LeviUdoh-17/waste_bin_ros/camera_ros/README.md

# ROS 2 node for libcamera

This ROS 2 node provides support for a variety of cameras via [libcamera](https://libcamera.org). Amongst others, this node supports V4L2 and [Raspberry Pi cameras](https://www.raspberrypi.com/documentation/computers/camera_software.html).

## Installation

Binary packages are available via the ROS package repository for some Linux and ROS distributions (check with `rosdep resolve camera_ros`). If it's available, you can install the DEB or RPM packages via:
```sh
# source a ROS distribution
source /opt/ros/$ROS_DISTRO/setup.bash
# DEB package
sudo apt install ros-$ROS_DISTRO-camera-ros
# RPM package
sudo dnf install ros-$ROS_DISTRO-camera-ros
```

> [!NOTE]
> This also installs the package [`libcamera`](https://index.ros.org/r/libcamera/) as dependency. This is the bloomed version of the official upstream repo at https://git.libcamera.org/libcamera/libcamera.git and may not contain full support for all Raspberry Pi camera modules. If you need full camera module support on Raspberry Pi, you have to build the "raspberrypi" fork from https://github.com/raspberrypi/libcamera manually.

## Build Instructions

### libcamera

The `camera_ros` node depends on libcamera version 0.1 or later. There are different ways to install this dependency:

- __System Package:__ Most Linux distributions provide a binary libcamera package. However, the Raspberry Pi OS uses a [custom libcamera fork](https://github.com/raspberrypi/libcamera) with additional support for newer camera modules. When using the distribution packages, you have to skip the `libcamera` rosdep key when resolving dependencies (`rosdep install [...] --skip-keys=libcamera`).

- __ROS Package:__ You can also install a newer version from the ROS repo (package `ros-$ROS_DISTRO-libcamera`). This package will be installed by default when building `camera_ros` from source and resolving the rosdep keys.

- __Source:__ Finally, you can always build libcamera from source. This is currently the only option for using the "raspberrypi" fork on Ubuntu. You can build libcamera as part of the ROS workspace using `colcon-meson`. This is recommended over a system-wide installation as it avoids conflicts with the system package. You will need to install the following dependencies:
    1. Install the libcamera build dependencies according to https://libcamera.org/getting-started.html#dependencies.
    2. Install `colcon-meson` via the package manager, `sudo apt install -y python3-colcon-meson`, or pip, `pip install colcon-meson`.

### camera_ros

The `camera_ros` package is built together with libcamera in a colcon workspace:
```sh
# create workspace
mkdir -p ~/camera_ws/src
cd ~/camera_ws/src

# check out libcamera
sudo apt -y install python3-colcon-meson
# Option A: official upstream
git clone https://git.libcamera.org/libcamera/libcamera.git
# Option B: raspberrypi fork with support for newer camera modules
# git clone https://github.com/raspberrypi/libcamera.git

# check out this camera_ros repository
git clone https://github.com/christianrauch/camera_ros.git

# resolve binary dependencies and build workspace
source /opt/ros/$ROS_DISTRO/setup.bash
cd ~/camera_ws/
rosdep install -y --from-paths src --ignore-src --rosdistro $ROS_DISTRO --skip-keys=libcamera
colcon build --event-handlers=console_direct+
```

If you are using a binary distribution of libcamera, you can skip adding this to the workspace. Additionally, if you want to use the bloomed libcamera package in the ROS repos, you can also omit `--skip-keys=libcamera` and have this binary dependency resolved automatically.

## Launching the Node

The package provides a standalone node executable:
```sh
ros2 run camera_ros camera_node
```
a composable node (`camera::CameraNode`):
```sh
ros2 component standalone camera_ros camera::CameraNode
```
and an example launch file for the composable node:
```sh
ros2 launch camera_ros camera.launch.py
```

## Interfaces

The camera node interfaces are compatible with the [`image_pipeline`](https://github.com/ros-perception/image_pipeline) stack. The node publishes the camera images and camera parameters and provides a service to set the camera parameters.

### Topics

| name | type | description |
| --- | --- | --- |
| `~/image_raw` | `sensor_msgs/msg/Image` | image |
| `~/image_raw/compressed` | `sensor_msgs/msg/CompressedImage` | image (compressed) |
| `~/camera_info` | `sensor_msgs/msg/CameraInfo` | camera parameters  |

### Services

| name | type | description |
| --- | --- | --- |
| `~/set_camera_info` | `sensor_msgs/srv/SetCameraInfo` | set camera parameters |

## Parameters

The node provides two sets of parameters:
1. static read-only parameters to configure the camera stream once at the beginning
2. dynamic parameters which are generated from the camera controls to change per-frame settings and which can be changed at runtime

Those parameters can be set on the command line:
```sh
# standalone executable
ros2 run camera_ros camera_node --ros-args -p param1:=arg1 -p param2:=arg2
# composable node
ros2 component standalone camera_ros camera::CameraNode -p param1:=arg1 -p param2:=arg2
```
or dynamically via the [ROS parameter API](https://docs.ros.org/en/rolling/Concepts/Basic/About-Parameters.html).

### Static Camera Stream Configuration

The camera stream is configured once when the node starts via the following static read-only parameters:

| name | type | description |
| --- | --- | --- |
| `camera` | `integer` or `string` | selects the camera by index (e.g. `0`) or by name (e.g. `/base/soc/i2c0mux/i2c@1/ov5647@36`) [default: `0`] |
| `role` | `string` | configures the camera with a `StreamRole` (possible choices: `raw`, `still`, `video`, `viewfinder`) [default: `viewfinder`] |
| `format` | `string` | a `PixelFormat` that is supported by the camera [default: auto] |
| `width`, `height` | `integer` | desired image resolution [default: auto] |
| `sensor_mode` | `string` | desired raw sensor format resolution (format: `width:height`) [default: auto] |
| `orientation` | `integer` | camera orientation in 90 degree steps (possible choices: `0`, `90`, `180`, `270`) [default: `0`] |
| `camera_info_url` | `string` | URL for a camera calibration YAML file (see [Calibration](#calibration)) [default: `~/.ros/camera_info/$NAME.yaml`] |
| `frame_id` | `string` | frame_id of the camera frame used in the header of the image messages |
| `use_node_time` | `boolean` | use node time instead of sensor timestamp for image message header [default: `false`] |

The configuration is done in the following order:
1. select camera via `camera`
2. configure camera stream via `role`
3. set the pixel format for the stream via `format`
4. set the image resolution for the stream via `width` and `height`
5. set the sensor mode resolution for the raw feed from camera to GPU

Each stream role only supports a discrete set of data stream configurations as a combination of the image resolution and pixel format. The selected stream configuration is validated at the end of this sequence and adjusted to the closest valid stream configuration.

By default, the node will select the first available camera and configures it with the default pixel format and image resolution. If a parameter has not been set, the node will print the available options and inform the user about the default choice.

The node avoids memory copies of the image data by directly mapping from a camera pixel format to a ROS image format, with the exception of converting between "raw" and "compressed" image formats when requested by the user. As an effect, not all pixel formats that are supported by the camera may be supported by the ROS image message. Hence, the options for `format` are limited to pixel formats that are supported by the camera and the raw ROS image message.

### Sensor Modes and Cropping

Most camera modules provide different sensor modes, some of which provide a smaller resolution version of the full picture, whereas others have a limited field-of-view, e.g. by allowing for the selection of a 3:2 image from a 16:9 sensor, a more native 'digital zoom' effect by cropping the picture etc. The benefit of this is to perform compute intensive tasks at the source (the sensor), rather than downstream in the GPU or in application code. Unless we specify the sensor mode we want, libcamera will automatically select one. Unfortunately, it is not guaranteed that the selected mode will be a full sensor mode, leading to a potential cropping of the picture.

Example: When configuring a 640x480 output stream on a Raspberry Pi Camera Module v2, libcamera will automatically choose a heavily cropped 640x480 sensor mode, leading to a digital zoom of ~2.5x.

See the [PiCamera2 Documentation, section 4.2.2.3](https://datasheets.raspberrypi.com/camera/picamera2-manual.pdf) for a detailed explanation. The [PiCamera Documentation](https://picamera.readthedocs.io/en/release-1.13/fov.html#sensor-modes) has a good visualization of the issue. Read the documentation of your camera to see what modes are available, and which (if any) raw formats are cropped.

### Dynamic Frame Configuration (controls)

The dynamic parameters are created at runtime by inspecting the [controls](https://libcamera.org/api-html/namespacelibcamera_1_1controls.html) that are exposed by the camera. The set of exposed controls is camera-dependent. The ROS parameters are directly formatted from the exposed controls, hence the parameter names match the control names.

libcamera does not expose the framerate directly as a parameter. Instead, the framerate range has to be converted to a duration:
$$\text{duration} = \frac{1}{\text{framerate}} \cdot 10^6 \\ µs$$
and then set via the control `FrameDurationLimits`, if it is exposed by the camera:
```sh
# set fixed framerate of 20 Hz (50 ms)
ros2 run camera_ros camera_node --ros-args -p FrameDurationLimits:="[50000,50000]"
```

## Calibration

The node uses the `CameraInfoManager` to manage the [camera parameters](https://docs.ros.org/en/rolling/p/image_pipeline/camera_info.html), such as the camera intrinsics for projection and distortion coefficients for rectification. Its tasks include loading the parameters from the calibration file, publishing them on `~/camera_info` and setting new parameters via service `~/set_camera_info`.

The URL for the camera calibration file can be set using the `camera_info_url` parameter, however it defaults to `~/.ros/camera_info/$NAME.yaml`. Note that when setting the URL manually, the provided string must be in the URL format, not a local file path (eg. `file:///home/nonroot/camera/calibration.yaml`). For more information, please take a look at the `CameraInfoManager` [API documentation](https://docs.ros.org/en/ros2_packages/rolling/api/camera_info_manager/generated/classcamera__info__manager_1_1CameraInfoManager.html).

If the camera has not been calibrated yet and the calibration file does not exist, the node will warn the user about the missing file (`Camera calibration file ~/.ros/camera_info/$NAME.yaml not found`) and publish zero-initialised intrinsic parameters. If you do not need to project between the 2D image plane and the 3D camera frame or rectify the image, you can safely ignore this.

To calibrate the camera and set the parameters, you can use the [`cameracalibrator`](https://docs.ros.org/en/rolling/p/camera_calibration/) from the `camera_calibration` package or any other node that interfaces with the `~/set_camera_info` service.

## Trouble Shooting

### Log Verbosity

More verbose logging can be enabled by setting the libcamera and node log levels:
```sh
LIBCAMERA_LOG_LEVELS=*:DEBUG ros2 run camera_ros camera_node --ros-args --log-level camera:=debug
```

### Debugging: Preparation

1. To debug the node with `gdb`, you have to make the debug symbols available:
    - **binary:** If you are using the binary bloom package (`ros-$ROS_DISTRO-camera-ros`), you also have to install the `dbgsym` packages:
        ```sh
        sudo apt install ros-$ROS_DISTRO-libcamera-dbgsym ros-$ROS_DISTRO-camera-ros-dbgsym
        ```
    - **source:** If you are compiling from source, you have to set the build type to `Debug`:
        ```sh
        colcon build --cmake-args -D CMAKE_BUILD_TYPE=Debug
        ```

2. Enable core dumps (a.k.a. "core files"):
    ```sh
    sudo sysctl -w kernel.core_pattern=/tmp/%e-%t.core
    ulimit -c unlimited
    ```

### Debugging: Crash Reports

To provide more information about a crash, generate a core dump or a backtrace with `gdb`. A core dump provides the full memory image of the process and is the best way to debug a process after it crashed. It can also be used to generate a backtrace.

> [!IMPORTANT]
> The core dump and backtrace contains references to the source code. Therefore, when providing either, you also have to mention for which git tag or commit hash this was generated.

#### core dump
If core dumps have been enabled, they will be generated automatically at `/tmp/camera_node-$TIME.core` (`$TIME` is seconds since the epoch). Make sure that you ran `ulimit -c unlimited` in the terminal and then reproduce the crash (`ros2 run camera_ros camera_node`), compress the core dump file (`gzip /tmp/camera_node-$TIME.core`), and share the compressed `/tmp/camera_node-$TIME.core.gz` for post-mortem debugging.

#### backtrace
Run the node and reprduce the crash with `--prefix` set:
```sh
LIBCAMERA_LOG_LEVELS=*:DEBUG ros2 run --prefix "gdb -ex='set pagination off' -ex=run -ex=backtrace --args" camera_ros camera_node --ros-args --log-level camera:=debug
```
If the process crashes, the backtrace will be shown. Paste the full `stdout` output, including the debug logs and backtrace, in a issue.

### Common Issues

#### No camera is detected (exception `no cameras available`)

For standard V4L2 camera devices, check that its connection is detected (`lsusb`) and that it is also detected by V4L2 (`v4l2-ctl --list-devices`).

On the Raspberry Pi, use `sudo vclog --msg` to inspect the VideoCore log messages for detected cameras. `vclog` is part of Raspberry Pi's `utils` repo at https://github.com/raspberrypi/utils. If this is not available in your distribution, such as Ubuntu, you have to build it from source:
```sh
# install build dependencies
sudo apt -y install --no-install-recommends wget ca-certificates gcc libc6-dev
# download vclog and build
wget https://raw.githubusercontent.com/raspberrypi/utils/refs/heads/master/vclog/vclog.c
gcc vclog.c -o vclog
# show VideoCore log messages
sudo ./vclog --msg
```

In the VideoCore log, you should find something like `Found camera 'ov5647' []` or `Found camera 'imx708' [...]`, which indicates the connected sensor, in these cases the _OmniVision OV5647_ and _Sony IMX708_. Look up this sensor in the [Raspberry Pi camera modules _Hardware Specification_](https://www.raspberrypi.com/documentation/accessories/camera.html#hardware-specification) and match the detected sensor with with the camera module. In this case, the _OmniVision OV5647_ image sensor belongs to the Camera Module 1 and the _Sony IMX708_ to the Camera Module 3.

If you are using a Raspberry Pi Camera Module, make sure that it is supported by the libcamera variant that you have installed. For example, the official upstream libcamera supports the Camera Module 1 (OmniVision OV5647), while the Camera Module 3 (Sony IMX708) is currently only supported by the "raspberrypi" fork of libcamera. To verify that your camera is working with libcamera, build the `cam` example from the libcamera repo and list the camera devices with `cam -l`. For a camera with the _OmniVision OV5647_ sensor, this will show something like `'ov5647' (/base/axi/pcie@120000/rp1/i2c@88000/ov5647@36)` and for the _Sony IMX708_ something like `'imx708_wide' (/base/axi/pcie@120000/rp1/i2c@88000/imx708@1a)`.

#### Buffer allocation issues (exception `Failed to allocate buffers`)

If the node fails to allocate buffers, you are probably running out of video memory. This is most likely the case on resource constrained devices with limited memory, such as the Raspberry Pi Zero.

To avoid this, either increase the video memory via `raspi-config`, or decrease the buffer size by reducing the image resolution (parameters `width` and `height`) and/or selecting a chroma subsampled or compressed pixel format that uses less bits per pixel (parameter `format`). For example, a raw format like `XRGB8888` uses 32 bits for each individual pixel, while a chroma subsampled format like `YUYV` only uses 32 bits per two pixels due to the subsampling of the colour components. For details on pixel formats, see the [Linux Kernel Image Formats documentation](https://www.kernel.org/doc/html/latest/userspace-api/media/v4l/pixfmt.html).
