LeviUdoh-17/waste_bin_ros/bin/bin_description/meshes/Hinge.stl

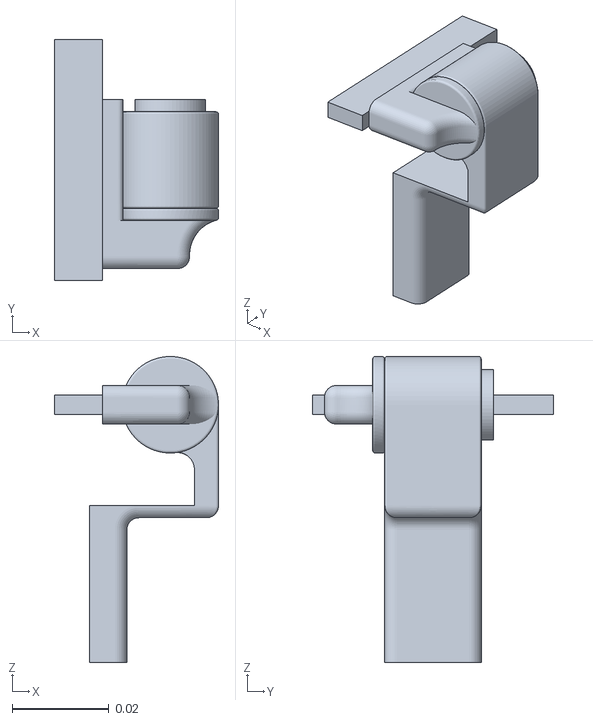
[picture p1: CAD file, 2026-09-11]
bin/bin_description/meshes/Hinge.stl
0.034 x 0.05 x 0.0634
