LeviUdoh-17/waste_bin_ros/bin/bin_description/meshes/camera.stl

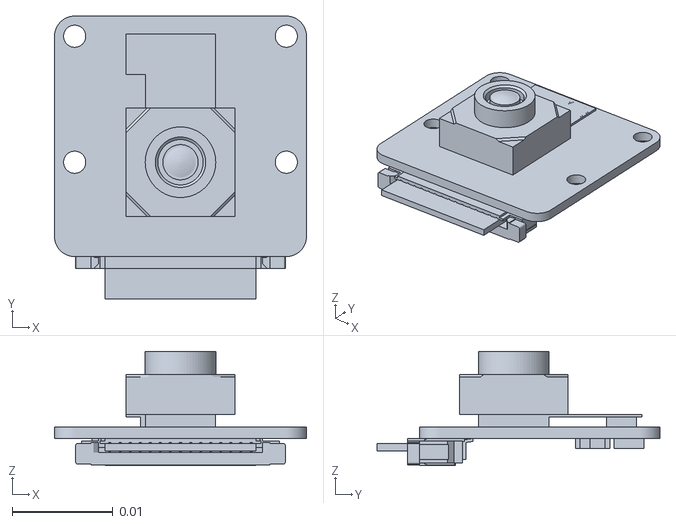
[picture p2: CAD file, 2026-09-11]
bin/bin_description/meshes/camera.stl
0.025 x 0.0281 x 0.0113
