LeviUdoh-17/waste_bin_ros/bin/bin_description/meshes/Left Wheel.stl

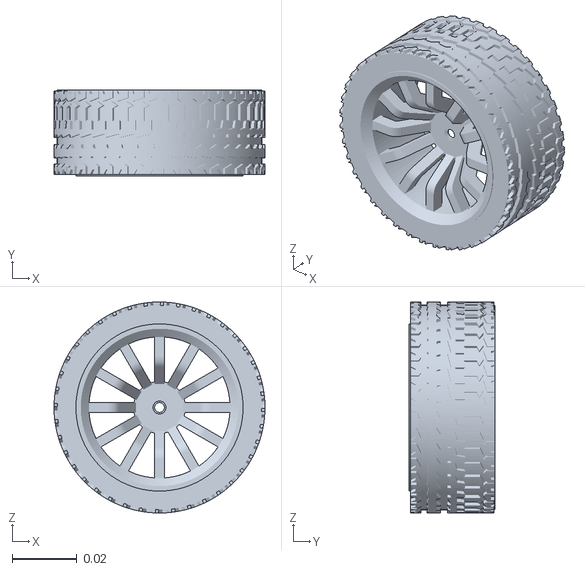
[picture p3: CAD file, 2026-09-11]
bin/bin_description/meshes/Left Wheel.stl
0.065 x 0.0264 x 0.065
