LeviUdoh-17/waste_bin_ros/bin/bin_description/meshes/Cover.stl

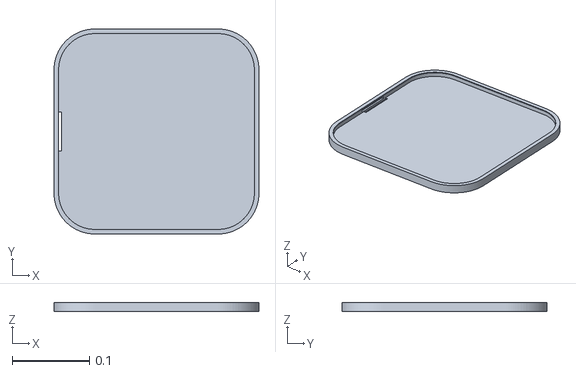
[picture p4: CAD file, 2026-09-11]
bin/bin_description/meshes/Cover.stl
0.266 x 0.266 x 0.012
