LeviUdoh-17/waste_bin_ros/bin/bin_description/meshes/Base.stl

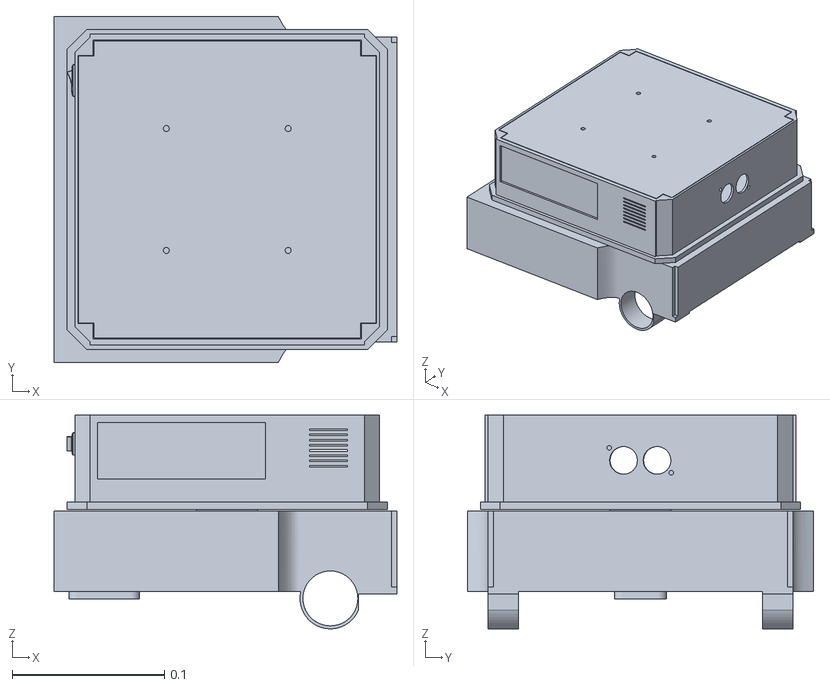
[picture p5: CAD file, 2026-09-11]
bin/bin_description/meshes/Base.stl
0.225 x 0.227 x 0.14
