LeviUdoh-17/waste_bin_ros/bin/bin_description/meshes/Right Motor.stl

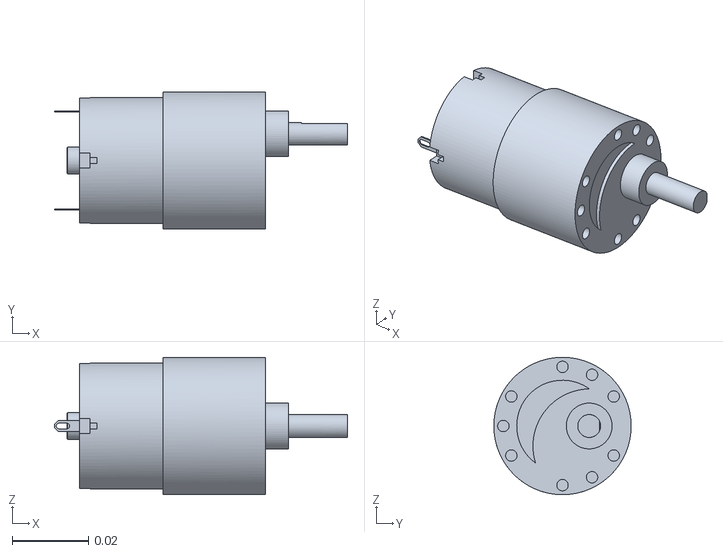
[picture p6: CAD file, 2026-09-11]
bin/bin_description/meshes/Right Motor.stl
0.0768 x 0.036 x 0.036
