LeviUdoh-17/waste_bin_ros/bin/bin_description/meshes/Caster Wheel.stl

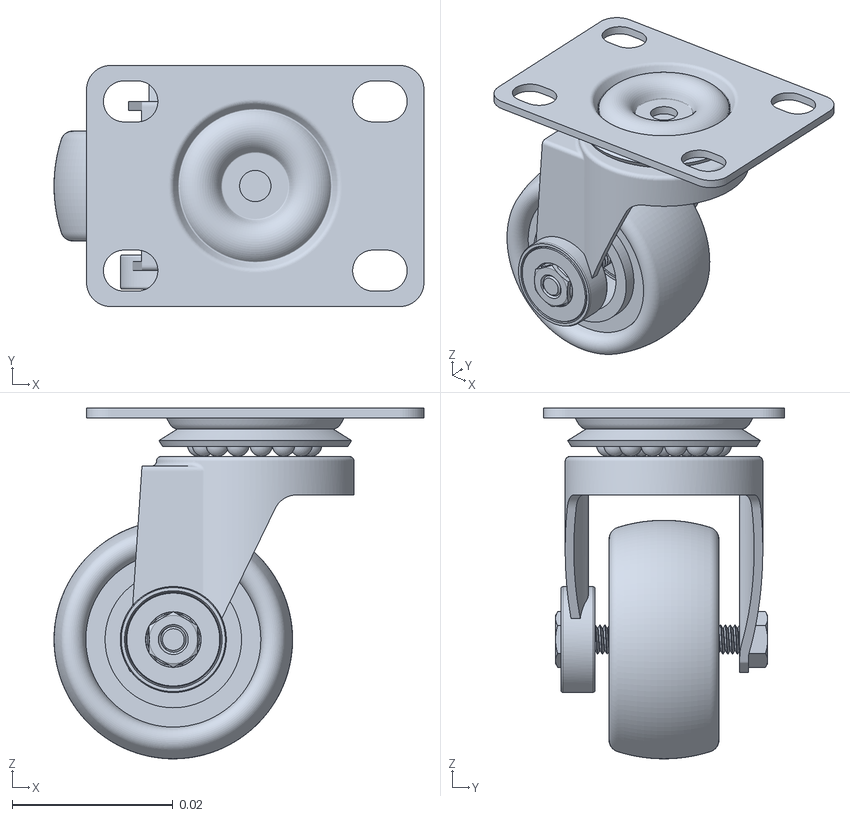
[picture p7: CAD file, 2026-09-11]
bin/bin_description/meshes/Caster Wheel.stl
0.046 x 0.03 x 0.0436
