LeviUdoh-17/waste_bin_ros/bin/bin_description/meshes/Bin.stl

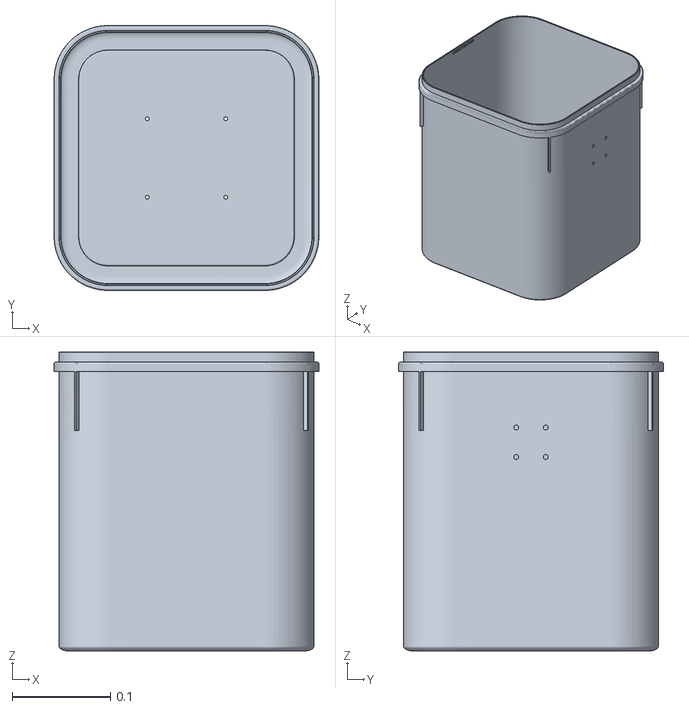
[picture p8: CAD file, 2026-09-11]
bin/bin_description/meshes/Bin.stl
0.27 x 0.27 x 0.305
