LeviUdoh-17/waste_bin_ros/bin/bin_description/meshes/Camera Case.stl

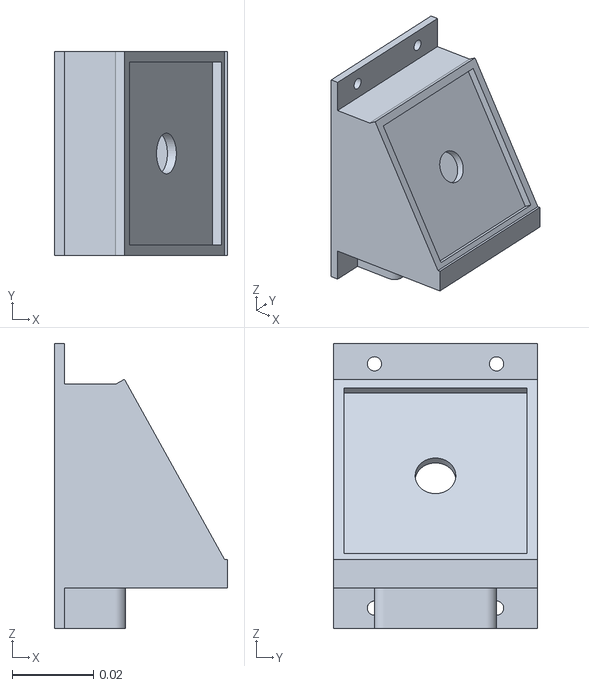
[picture p9: CAD file, 2026-09-11]
bin/bin_description/meshes/Camera Case.stl
0.0425 x 0.05 x 0.07
