LeviUdoh-17/waste_bin_ros/(list of files, cad)

Other CAD files:
bin/bin_description/meshes/Left Motor.stl
